Tynogc/PowerSystem/README.md

# PowerSystem
Some Switching regulators, converting a 4S LiPo into 5V and 12V Power Source

Bauteile:
Spuhle 12µH: SRR1260-120MCT-ND
Spuhle 3.3µH: SRN8040-3R3YCT-ND
Spuhle 2.2µH: XFL4020-222MEB (Bei Mouser) Oder gleichwertigen bei DigiKey
