Tynogc/PowerSystem/webench_design_4079392_1_264309184.pdf

## WEBENCH ® Design Report

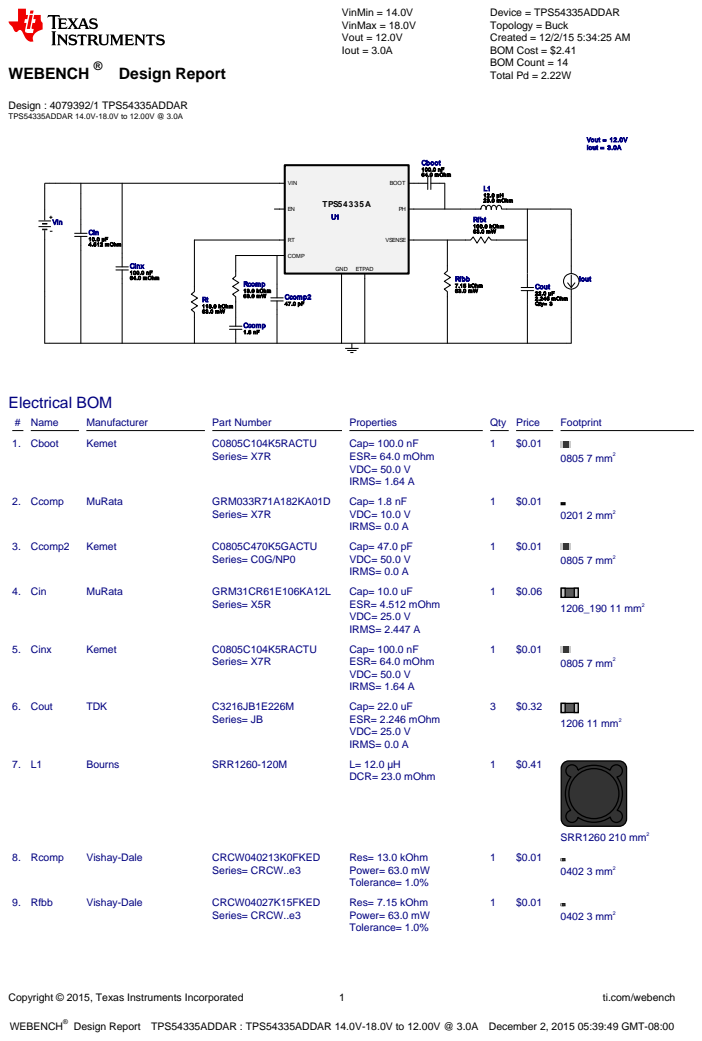
[picture p1: page 1]
Copyright © 2015, Texas Instruments Incorporated; ti.com/webench; WEBENCH®; Design : 4079392/1 TPS54335ADDAR TPS54335ADDAR 14.0V-18.0V to 12.00V @ 3.0A; VinMin = 14.0V VinMax = 18.0V Vout = 12.0V Iout = 3.0A; Device = TPS54335ADDAR Topology = Buck Created = 12/2/15 5:34:25 AM BOM Cost = $2.41 BOM Count = 14 Total Pd = 2.22W; Cboot 100.0 nF 64.0 mOhm; Ccomp 1.8 nF; Ccomp2 47.0 pF; Cin 10.0 µF 4.512 mOhm; Cinx 100.0 nF 64.0 mOhm; Cout 22.0 µF 2.246 mOhm Qty= 3; L1 12.0 µH 23.0 mOhm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

Design Report TPS54335ADDAR : TPS54335ADDAR 14.0V-18.0V to 12.00V @ 3.0A December 2, 2015 05:39:49 GMT-08:00

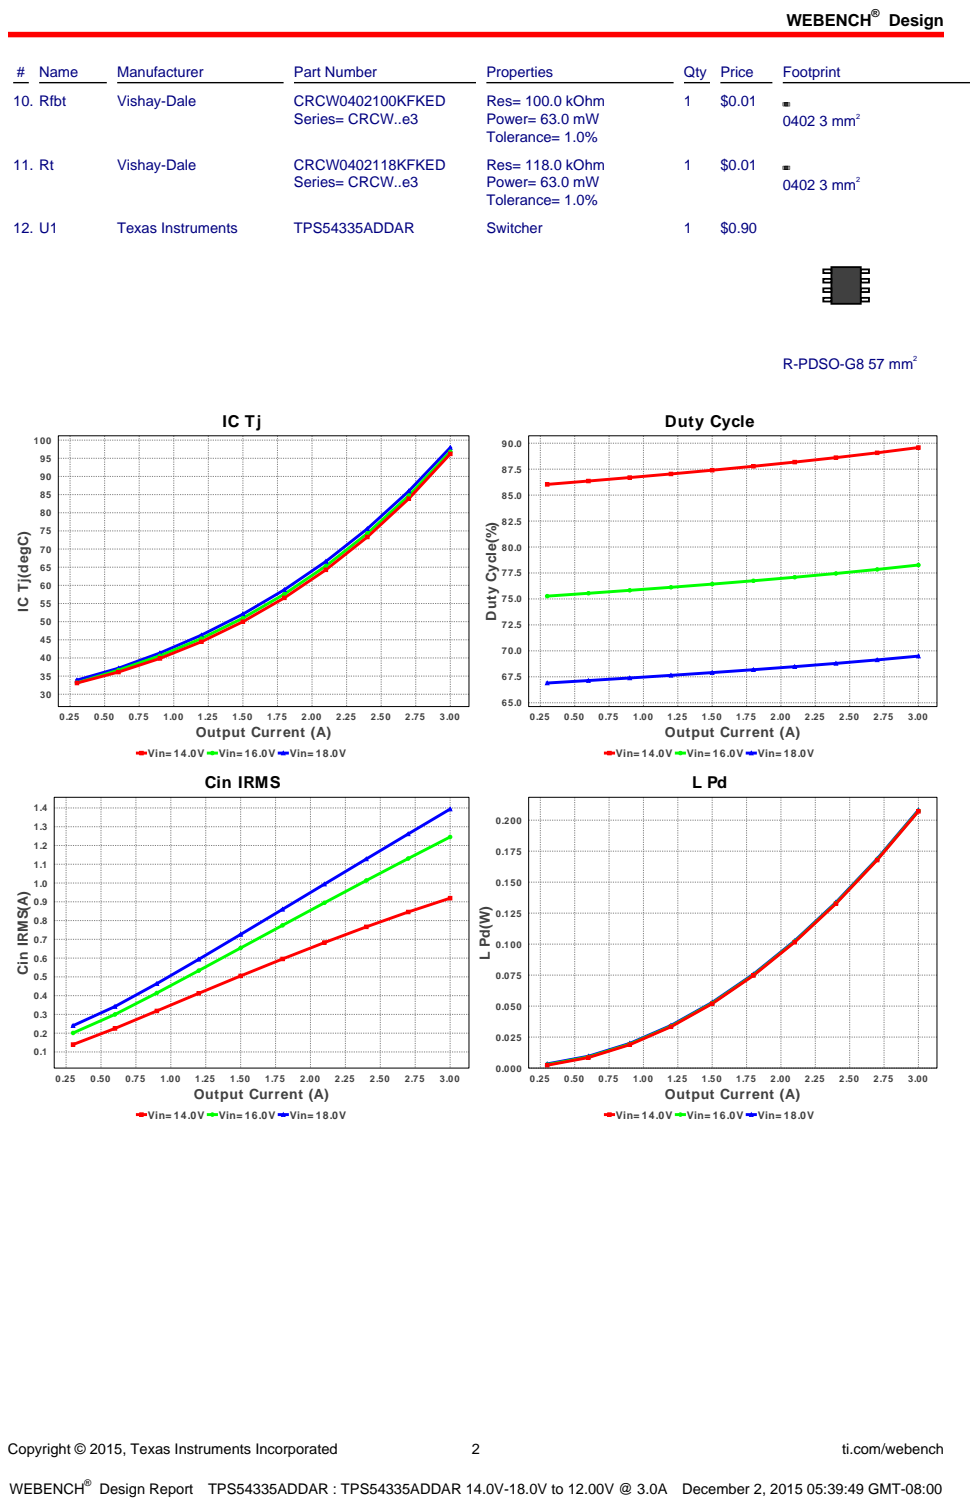
[picture p2: page 2]
Design; Copyright © 2015, Texas Instruments Incorporated; ti.com/webench; # Name; Manufacturer; Part Number; Properties; Qty Price; Footprint; 10. Rfbt; Vishay-Dale; CRCW0402100KFKED; Series= CRCW..e3; Res= 100.0 kOhm Power= 63.0 mW Tolerance= 1.0%; 0402 3 mm²; CRCW0402118KFKED; Res= 118.0 kOhm Power= 63.0 mW Tolerance= 1.0%; Texas Instruments; TPS54335ADDAR; Switcher; R-PDSO-G8 57 mm²; 3.00 Output Current (A); Duty Cycle; Duty Cycle(%); Cin IRMS(A)

IC Tj(degC)

Vin= 14.0V Vin= 16.0V Vin= 18.0V
Cin IRMS

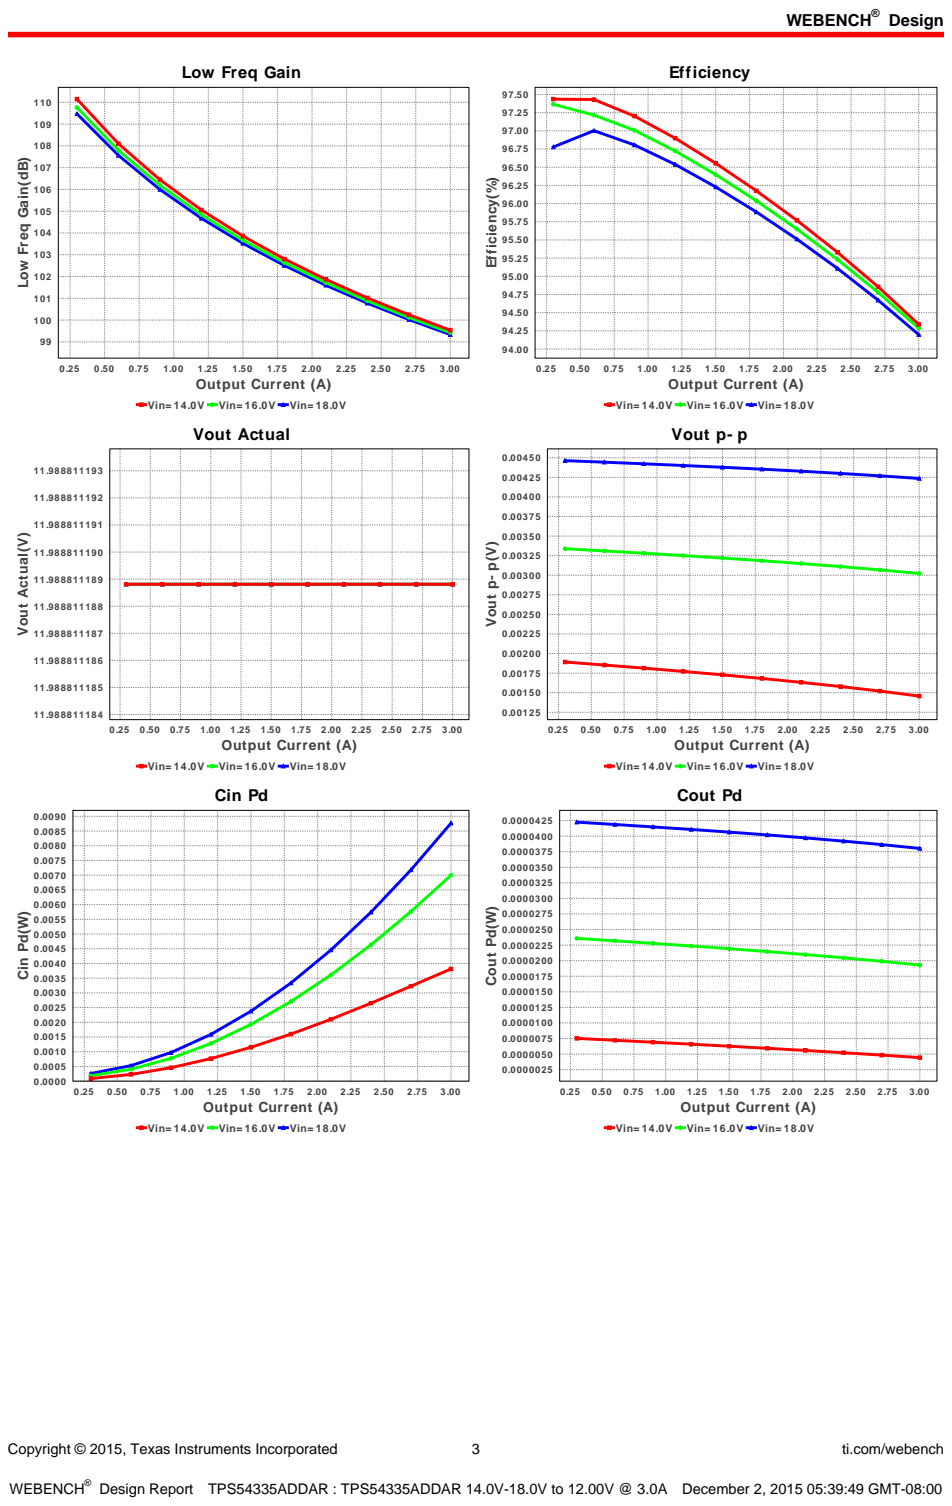
[picture p3: page 3]
Copyright © 2015, Texas Instruments Incorporated; ti.com/webench; 3.00 Output Current (A); Efficiency; Efficiency(%); 0.25 0.50 0.75 1.00 1.25 1.50 1.75 2.00 2.25 2.50 2.75 3.00 Output Current (A); Vout Actual(V); Vout p- p(V); Cin Pd; Cin Pd(W); Cout Pd; Cout Pd(W)

Low Freq Gain

Low Freq Gain(dB)

Vin= 14.0V Vin= 16.0V Vin= 18.0V
Vout Actual

Vout p- p

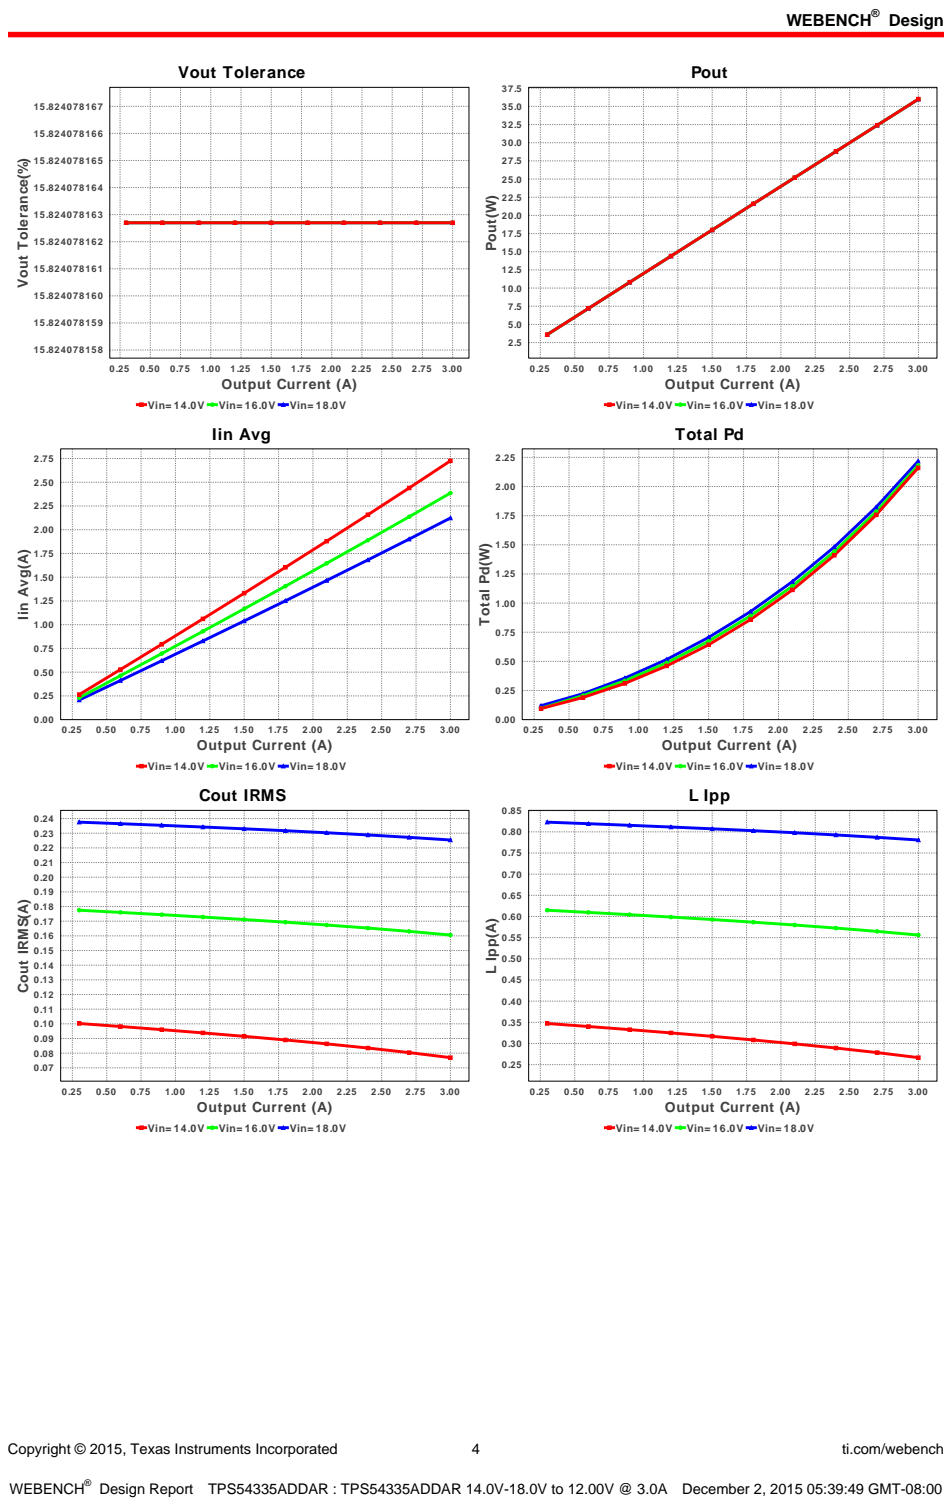
[picture p4: page 4]
Copyright © 2015, Texas Instruments Incorporated; ti.com/webench; Vout Tolerance; 0.25 0.50 0.75 1.00 1.25 1.50 1.75 2.00 2.25 2.50 2.75 3.00 Output Current (A); Vout Tolerance(%); Pout; 3.00 Output Current (A); Pout(W); Iin Avg; Iin Avg(A); Total Pd; Total Pd(W); Cout IRMS(A); L Ipp; L Ipp(A)

Vin= 14.0V Vin= 16.0V Vin= 18.0V

Cout IRMS

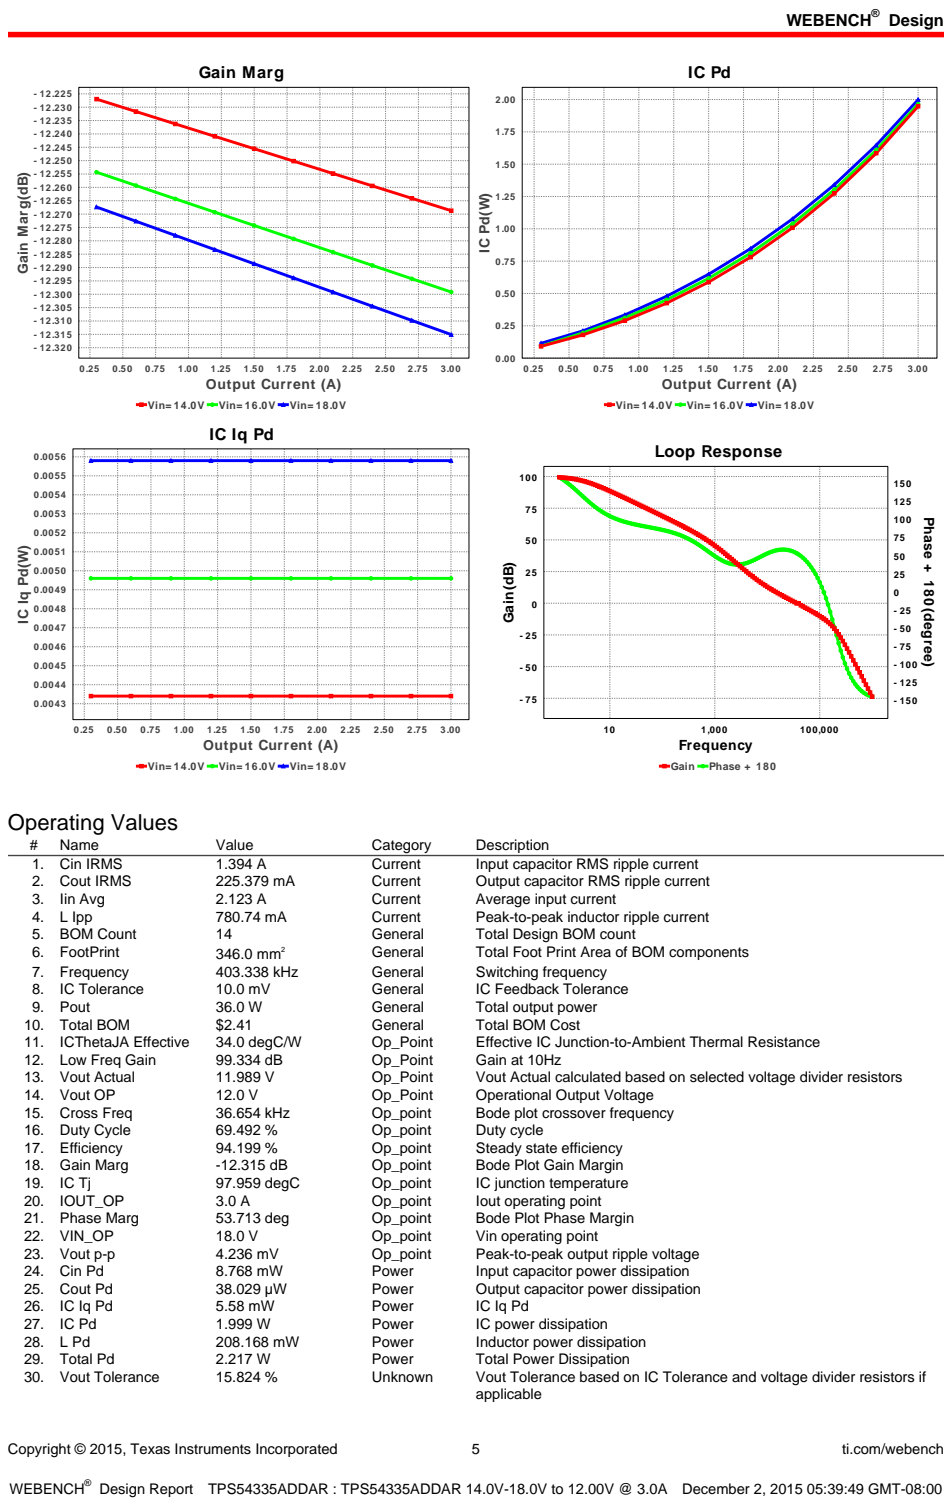
[picture p5: page 5]
Copyright © 2015, Texas Instruments Incorporated; ti.com/webench; Gain Marg; 0.25 0.50 0.75 1.00 1.25 1.50 1.75 2.00 2.25 2.50 2.75 3.00 Output Current (A); 3.00 Output Current (A); Loop Response; Gain Phase + 180; 100,000 Frequency; Gain(dB); Phase + 180(degree); Operating Values; Name; Value; Category; Description; 1. Cin IRMS; Current; Input capacitor RMS ripple current; 2. Cout IRMS; Output capacitor RMS ripple current; 3. Iin Avg; Average input current; 4. L Ipp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

Gain Marg(dB)

Vin= 14.0V Vin= 16.0V Vin= 18.0V

Copyright © 2015, Texas Instruments Incorporated | 6 | ti.com/webench

## Design Inputs

# | Name | Value | Description

1. Iout | 3.0 | Maximum Output Current
2. VinMax | 18.0 | Maximum input voltage
3. VinMin | 14.0 | Minimum input voltage
4. Vout | 12.0 | Output Voltage
5. base_pn | TPS54335A | Base Product Number
6. source | DC | Input Source Type
7. Ta | 30.0 | Ambient temperature

## Design Assistance

1. TPS54335A Product Folder : http://www.ti.com/product/TPS54335A : contains the data sheet and other resources.

Texas Instruments' WEBENCH simulation tools attempt to recreate the performance of a substantially equivalent physical implementation
of the design. Simulations are created using Texas Instruments' published specifications as well as the published specifications of other device manufacturers. While Texas Instruments does update this information periodically, this information may not be current at the time the simulation is built. Texas Instruments does not warrant the accuracy or completeness of the specifications or any information contained therein. Texas Instruments does not warrant that any designs or recommended parts will meet the specifications you entered, will be suitable for your application or fit for any particular purpose, or will operate as shown in the simulation in a physical implementation. Texas Instruments does not warrant that the designs are production worthy.
You should completely validate and test your design implementation to confirm the system functionality for your application prior to production.
Use of Texas Instruments' WEBENCH simulation tools is subject to Texas Instruments' Site Terms and Conditions of Use. (http://www.ti.com/corp/docs/legal/termsofuse.shtml) Prototype boards based on WEBENCH created designs are provided AS IS without warranty of any kind for evaluation and testing purposes and are subject to the terms of the Evaluation License Agreement. (http://www.ti.com/corp/docs/legal/termsofuse_estore.shtml)
