Tynogc/PowerSystem/webench_design_4079392_3_433164948.pdf

## WEBENCH ® Design Report

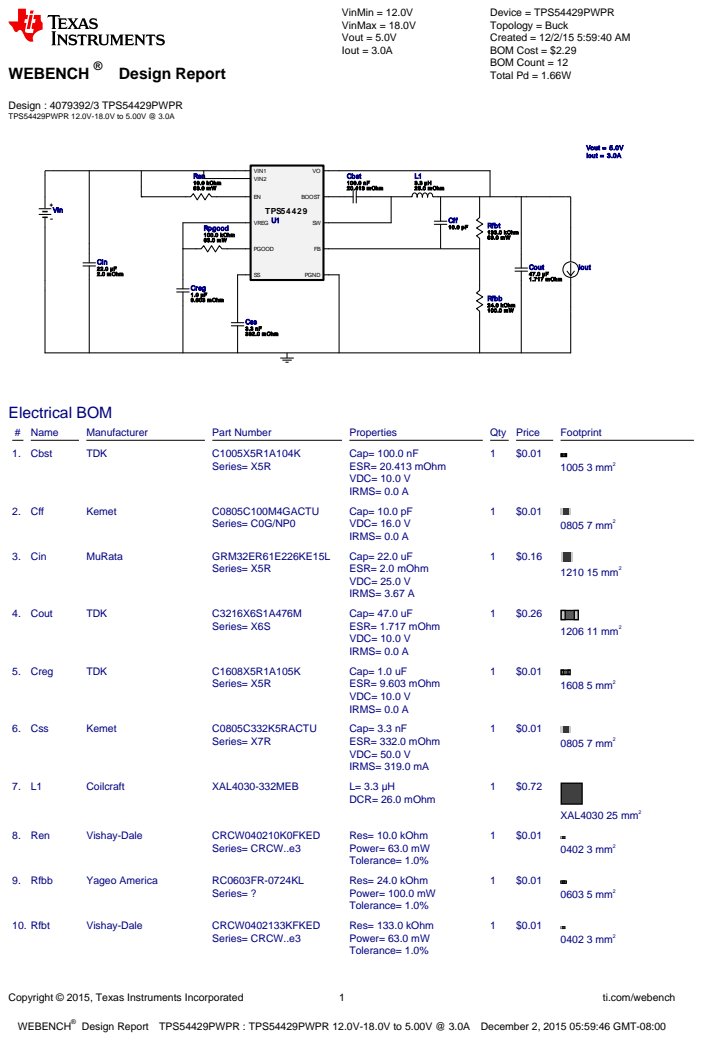
[picture p6: page 1]
Copyright © 2015, Texas Instruments Incorporated; ti.com/webench; WEBENCH®; Design : 4079392/3 TPS54429PWPR TPS54429PWPR 12.0V-18.0V to 5.00V @ 3.0A; VinMin = 12.0V VinMax = 18.0V Vout = 5.0V Iout = 3.0A; Device = TPS54429PWPR Topology = Buck Created = 12/2/15 5:59:40 AM BOM Cost = $2.29 BOM Count = 12 Total Pd = 1.66W; Cff 10.0 pF; Cbst 100.0 nF 20.413 mOhm; Cin 22.0 µF 2.0 mOhm; Cout 47.0 µF 1.717 mOhm; Creg 1.0 µF 9.603 mOhm; Css 3.3 nF 332.0 mOhm; L1 3.3 µH 26.0 mOhm; Ren 10.0 kOhm 63.0 mW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

Design Report TPS54429PWPR : TPS54429PWPR 12.0V-18.0V to 5.00V @ 3.0A December 2, 2015 05:59:46 GMT-08:00

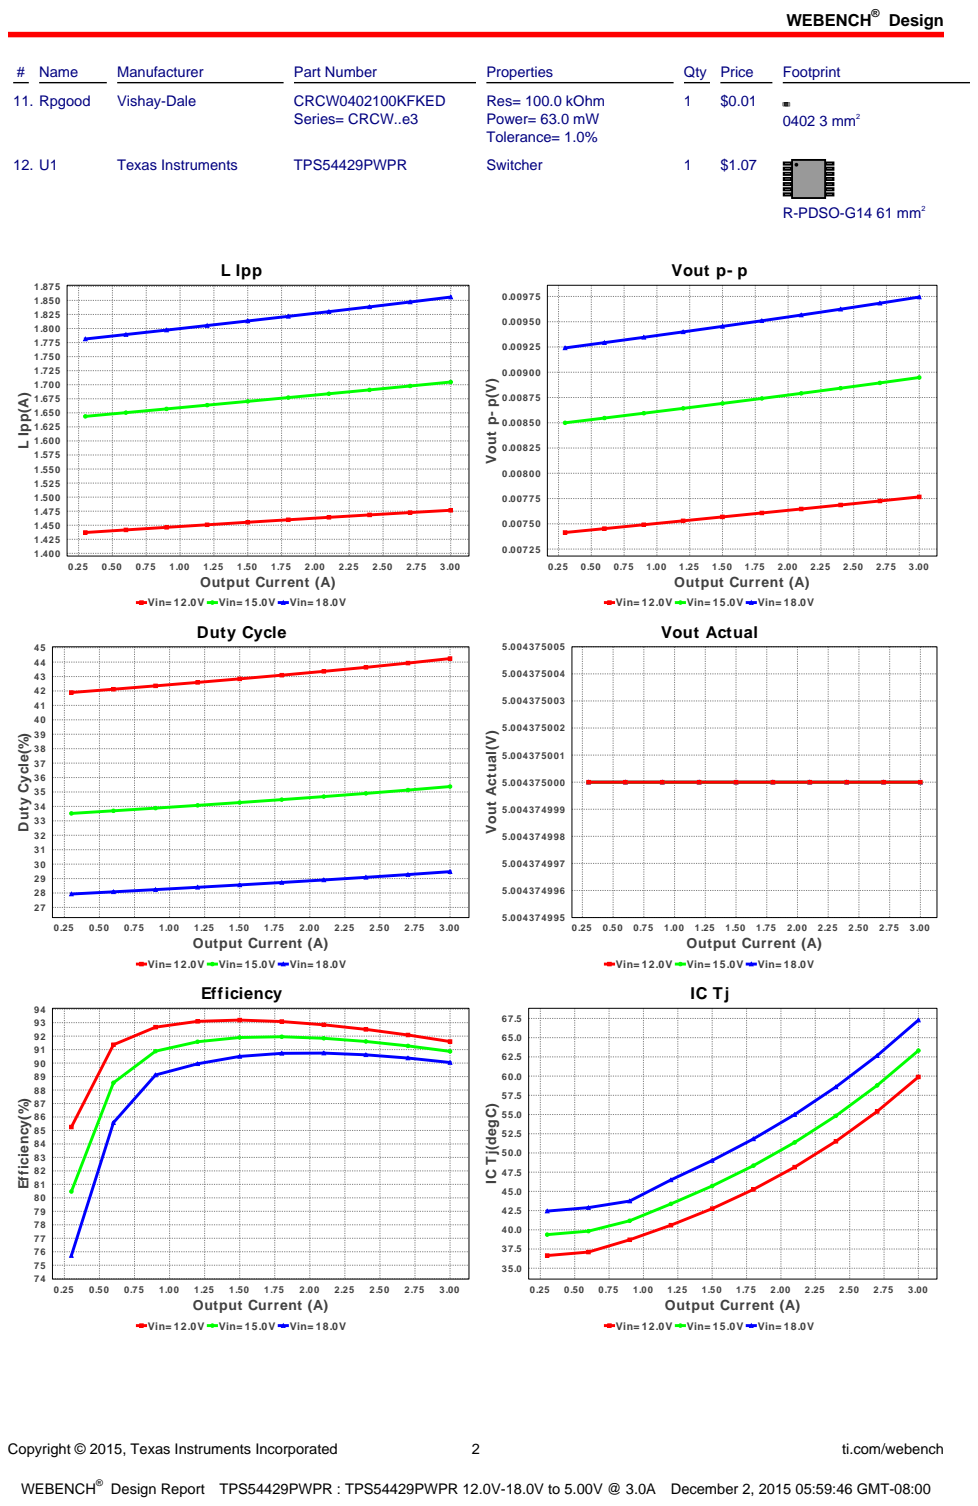
[picture p7: page 2]
Design; Copyright © 2015, Texas Instruments Incorporated; ti.com/webench; # Name; Manufacturer; Part Number; Properties; Qty Price; Footprint; 11. Rpgood; Vishay-Dale; CRCW0402100KFKED; Series= CRCW..e3; Res= 100.0 kOhm Power= 63.0 mW Tolerance= 1.0%; 0402 3 mm²; Texas Instruments; TPS54429PWPR; Switcher; R-PDSO-G14 61 mm²; L Ipp; 3.00 Output Current (A); L Ipp(A); Vout p- p; 0.25 0.50 0.75 1.00 1.25 1.50 1.75 2.00 2.25 2.50 2.75 3.00 Output Current (A); Vout p- p(V); Duty Cycle(%)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

Vin= 12.0V Vin= 15.0V Vin= 18.0V
Duty Cycle

Vout Actual

Efficiency

IC Tj(degC)

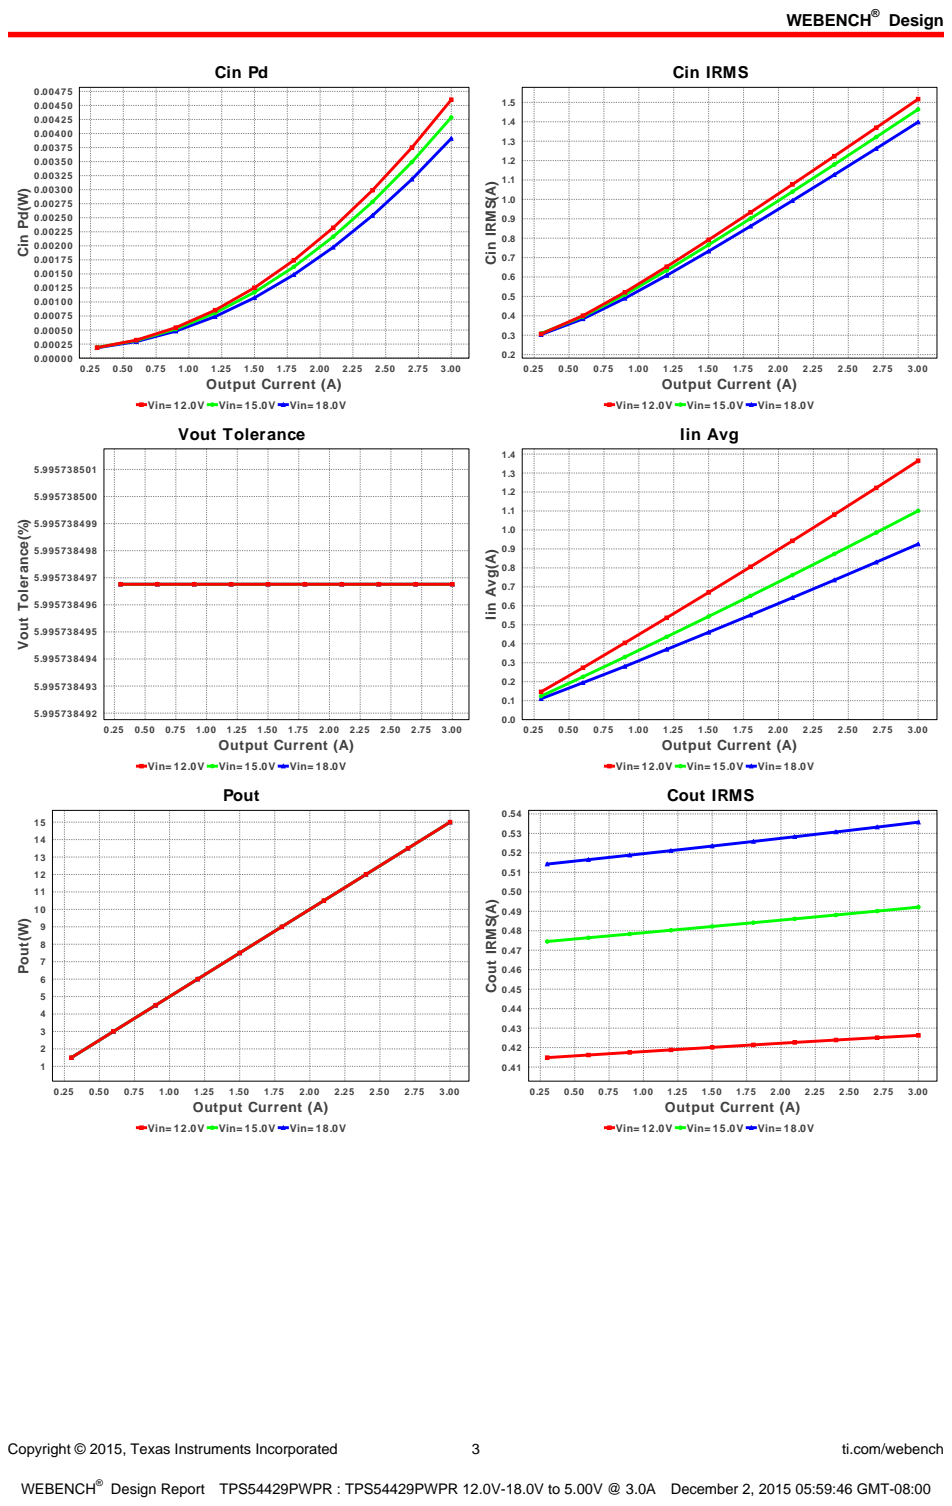
[picture p8: page 3]
Copyright © 2015, Texas Instruments Incorporated; ti.com/webench; Cin Pd; 0.25 0.50 0.75 1.00 1.25 1.50 1.75 2.00 2.25 2.50 2.75 3.00 Output Current (A); Cin Pd(W); Cin IRMS; 3.00 Output Current (A); Cin IRMS(A); Vout Tolerance(%); Iin Avg; Iin Avg(A); Pout; Pout(W); Cout IRMS(A)

Vin= 12.0V Vin= 15.0V Vin= 18.0V
Vout Tolerance

Cout IRMS

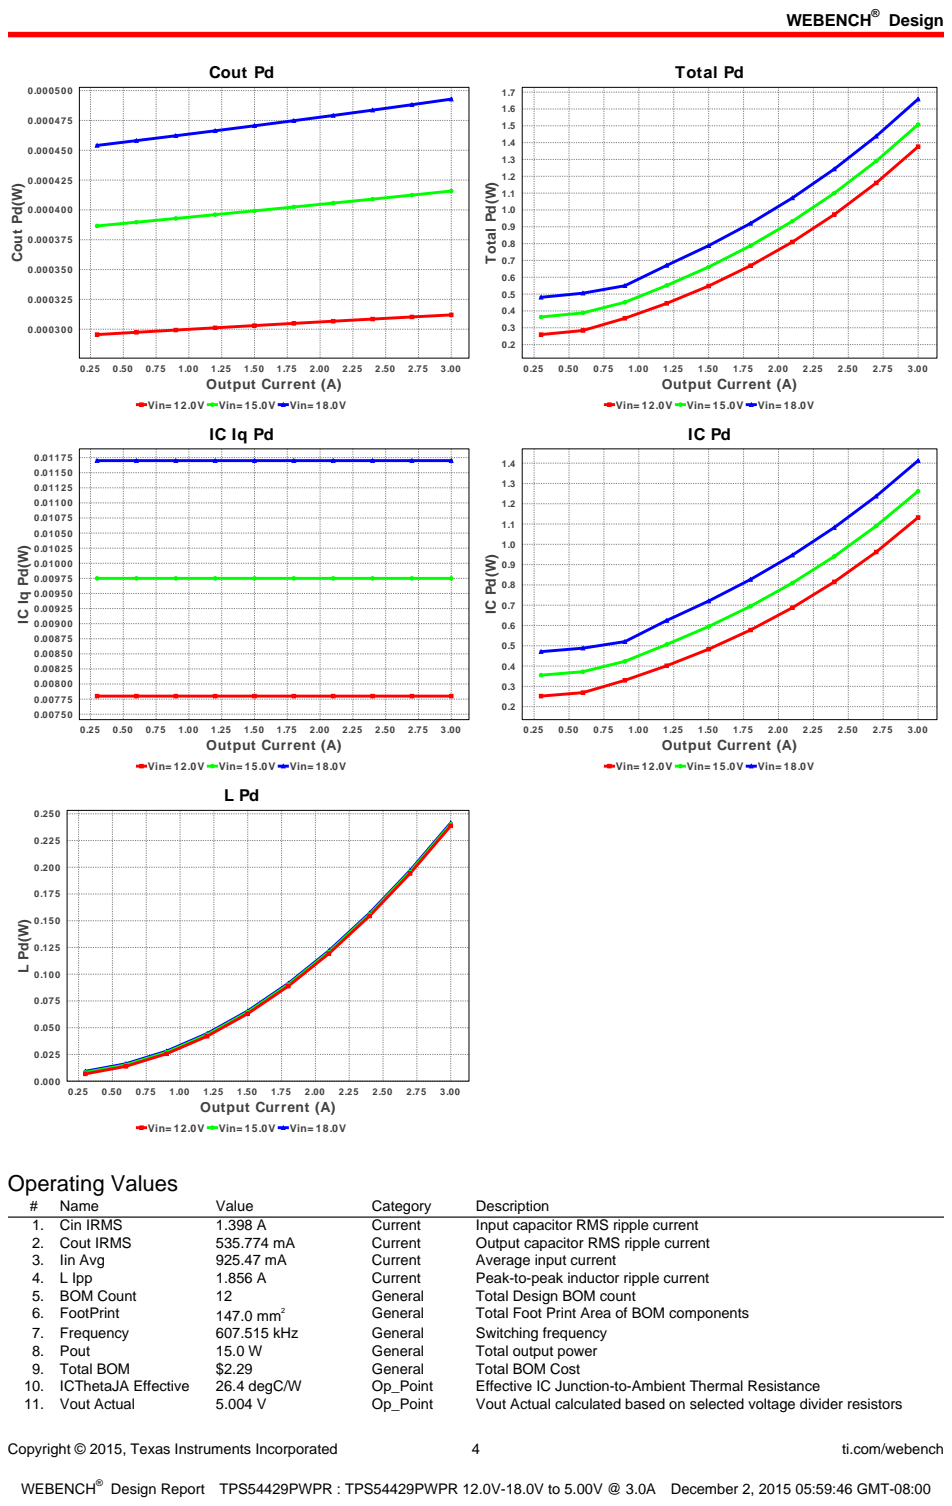
[picture p9: page 4]
Copyright © 2015, Texas Instruments Incorporated; ti.com/webench; Cout Pd; 0.25 0.50 0.75 1.00 1.25 1.50 1.75 2.00 2.25 2.50 2.75 3.00 Output Current (A); Cout Pd(W); Total Pd; 3.00 Output Current (A); Total Pd(W); Operating Values; Name; Value; Category; Description; 1. Cin IRMS; Current; Input capacitor RMS ripple current; 2. Cout IRMS; Output capacitor RMS ripple current; 3. Iin Avg; Average input current; 4. L Ipp; Peak-to-peak inductor ripple current; 5. BOM Count; General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

Vin= 12.0V Vin= 15.0V Vin= 18.0V

Copyright © 2015, Texas Instruments Incorporated | 5 | ti.com/webench
# | Name | Value | Category | Description

12. Vout OP | 5.0 V | Op_Point | Operational Output Voltage
13. Duty Cycle | 29.479 % | Op_point | Duty cycle
14. Efficiency | 90.044 % | Op_point | Steady state efficiency
15. IC Tj | 67.289 degC | Op_point | IC junction temperature
16. IOUT_OP | 3.0 A | Op_point | Iout operating point
17. VIN_OP | 18.0 V | Op_point | Vin operating point
18. Vout p-p | 9.744 mV | Op_point | Peak-to-peak output ripple voltage
19. Cin Pd | 3.911 mW | Power | Input capacitor power dissipation
20. Cout Pd | 492.871 µW | Power | Output capacitor power dissipation
21. IC Iq Pd | 11.7 mW | Power | IC Iq Pd
22. IC Pd | 1.412 W | Power | IC power dissipation
23. L Pd | 241.463 mW | Power | Inductor power dissipation
24. Total Pd | 1.659 W | Power | Total Power Dissipation
25. Vout Tolerance | 5.996 % | Unknown | Vout Tolerance based on IC Tolerance and voltage divider resistors if
| | | | applicable

## Design Inputs

# | Name | Value | Description

1. Iout | 3.0 | Maximum Output Current
2. VinMax | 18.0 | Maximum input voltage
3. VinMin | 12.0 | Minimum input voltage
4. Vout | 5.0 | Output Voltage
5. base_pn | TPS54429 | Base Product Number
6. source | DC | Input Source Type
7. Ta | 30.0 | Ambient temperature

## Design Assistance

1. TPS54429 Product Folder : http://www.ti.com/product/TPS54429 : contains the data sheet and other resources.

Texas Instruments' WEBENCH simulation tools attempt to recreate the performance of a substantially equivalent physical implementation
of the design. Simulations are created using Texas Instruments' published specifications as well as the published specifications of other device manufacturers. While Texas Instruments does update this information periodically, this information may not be current at the time the simulation is built. Texas Instruments does not warrant the accuracy or completeness of the specifications or any information contained therein. Texas Instruments does not warrant that any designs or recommended parts will meet the specifications you entered, will be suitable for your application or fit for any particular purpose, or will operate as shown in the simulation in a physical implementation. Texas Instruments does not warrant that the designs are production worthy.
You should completely validate and test your design implementation to confirm the system functionality for your application prior to production.
Use of Texas Instruments' WEBENCH simulation tools is subject to Texas Instruments' Site Terms and Conditions of Use. (http://www.ti.com/corp/docs/legal/termsofuse.shtml) Prototype boards based on WEBENCH created designs are provided AS IS without warranty of any kind for evaluation and testing purposes and are subject to the terms of the Evaluation License Agreement. (http://www.ti.com/corp/docs/legal/termsofuse_estore.shtml)
