Tynogc/PowerSystem/PwrRails.kicad_pcb

## KiCad design PwrRails.kicad_pcb (2015-12-04)

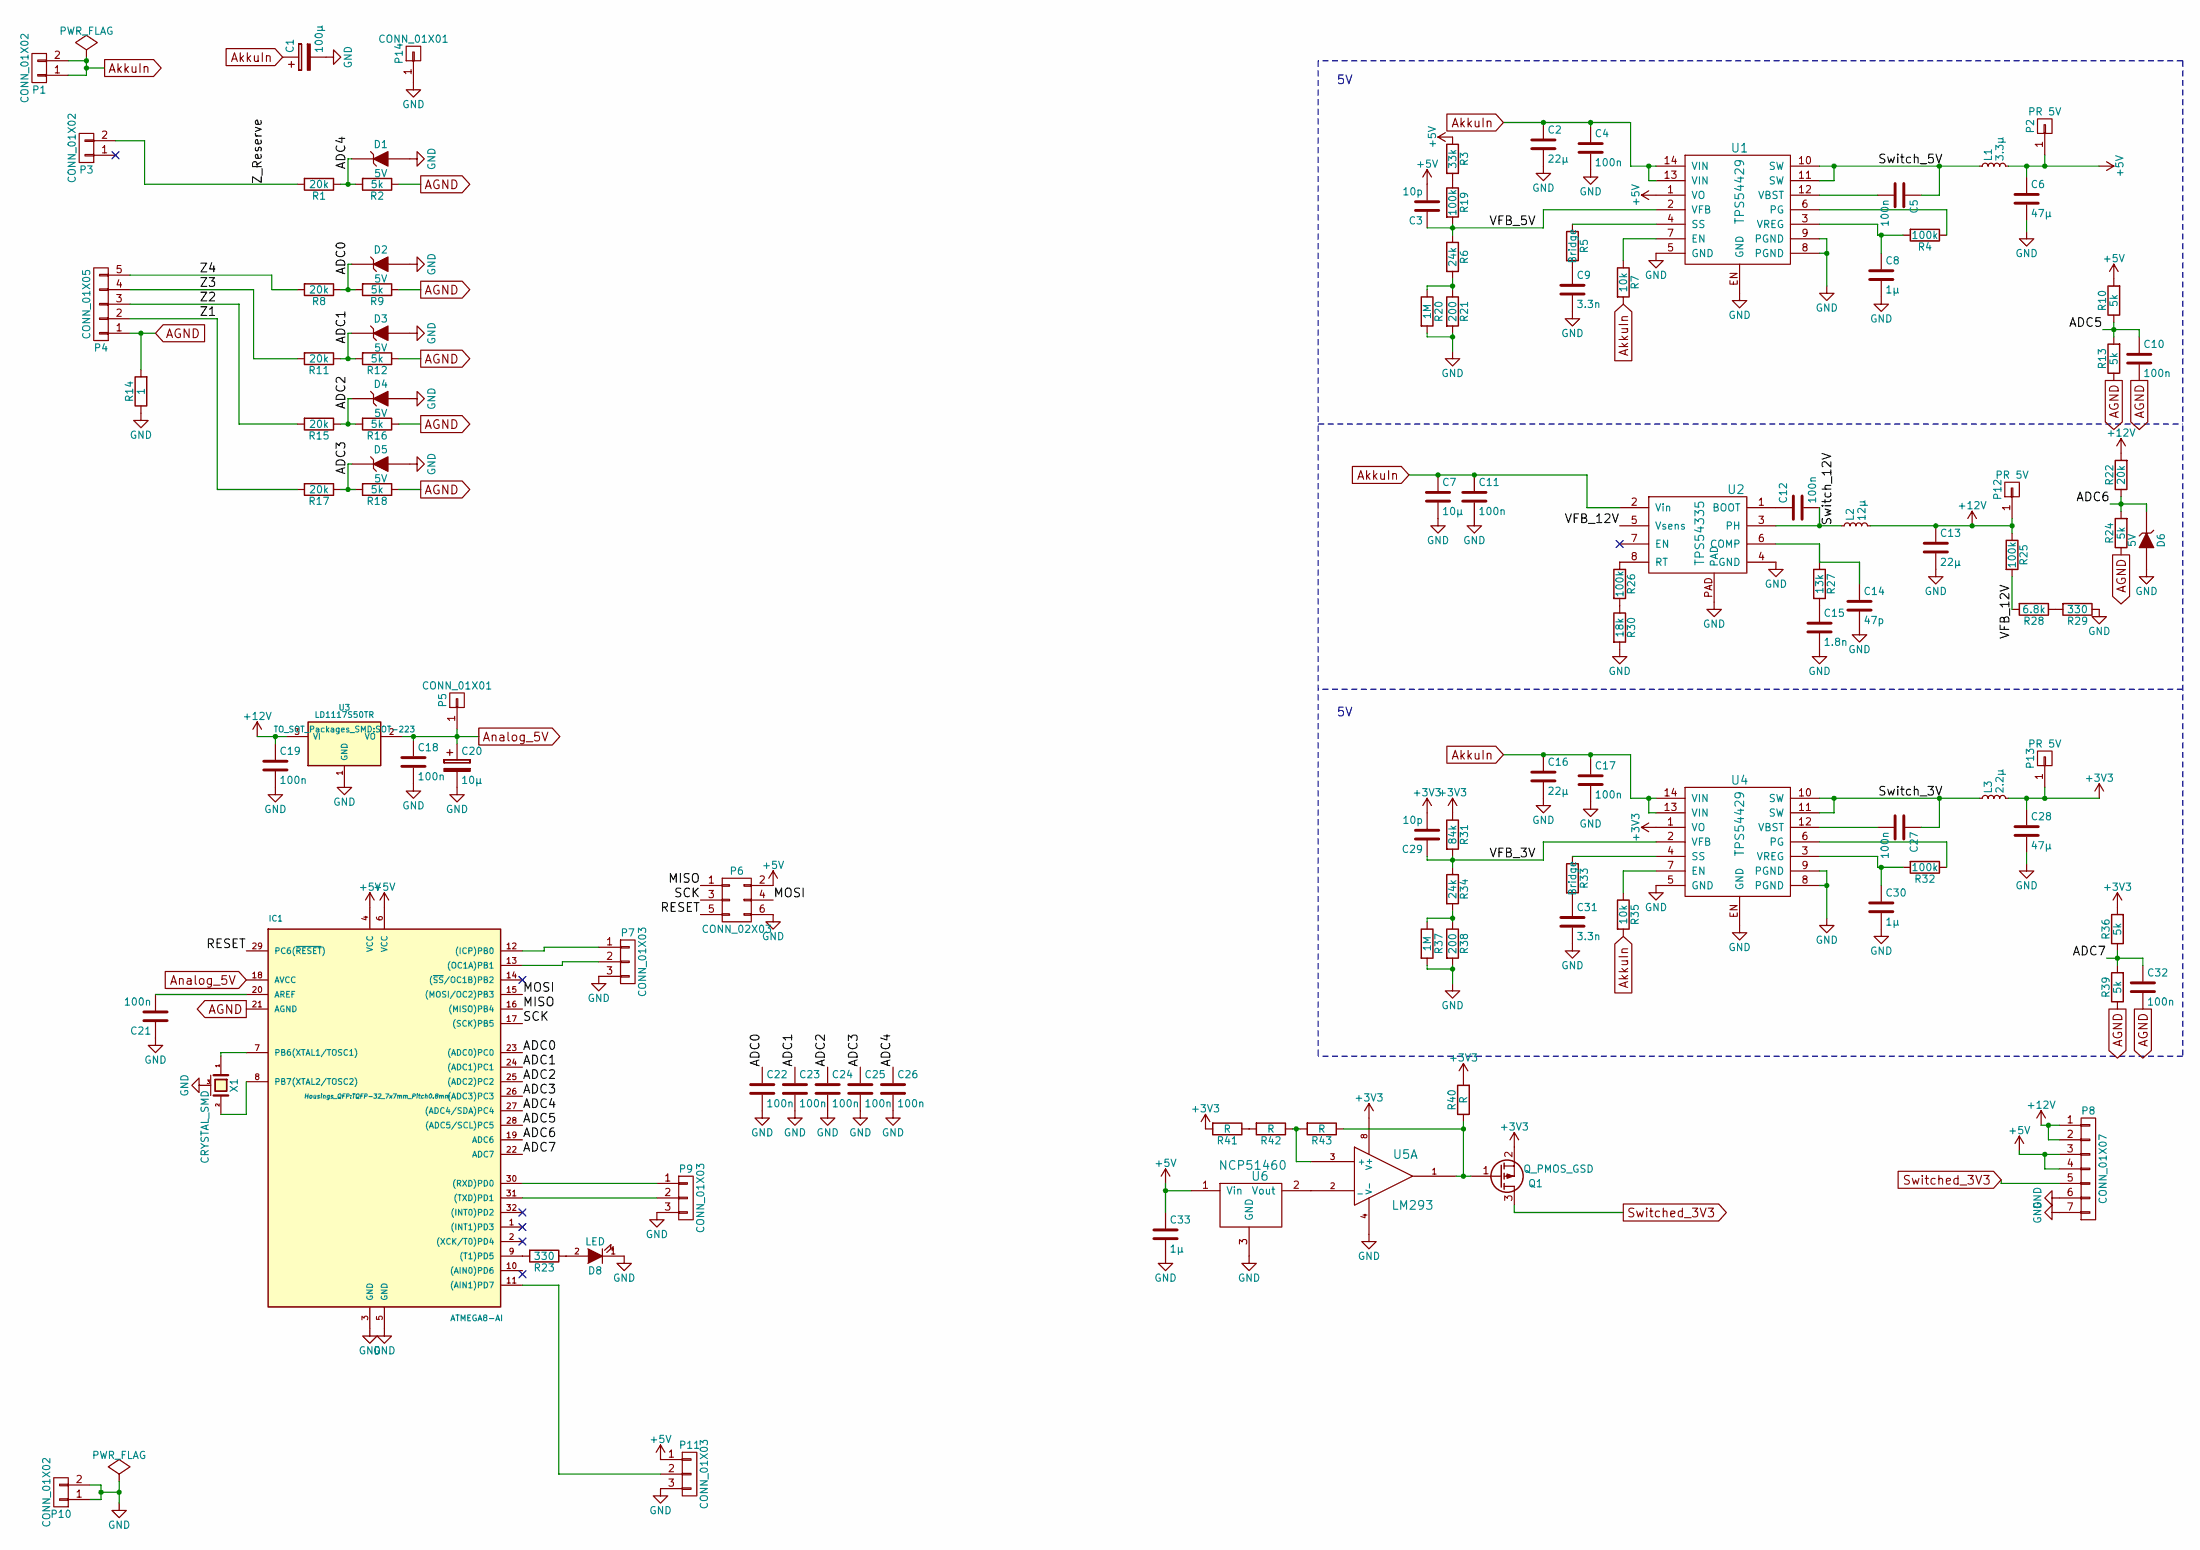
[picture p10: schematic PwrRails.sch]

Parts:
C1: 100µ; C_Radial_D8_L13_P3.8
C2, C16: 22µ; C_1210
C3, C29: 10p; C_0603
C4, C5, C10, C11, C12, C17, C18, C19, C21, C22, C23, C24, C25, C26, C27, C32: 100n; C_0805
C6, C28: 47µ; C_1206
C7, C20: 10µ; C_1206
C8, C30, C33: 1µ; C_0805
C9, C31: 3.3n; C_0805
C13: 22µ; C_1206
C14: 47p; C_0603
C15: 1.8n; C_0603
D1, D2, D3, D4, D5, D6: 5V; MiniMELF_Standard
D8: LED; LED-0805
IC1: ATMEGA8-AI; TQFP-32_7x7mm_Pitch0.8mm
L1: 3.3µ; Z_Borus_SRN8040
L2: 12µ; Neosid_Inductor_SM-NE127
L3: 2.2µ; Z_Coilcraft_XFL4020
P1, P10: CONN_01X02; Screw_Connector_5,08mm_x2
P2, P12, P13: PR 5V; Measurement_Point_Square-SMD-Pad_Big
P3: CONN_01X02; Socket_Strip_Straight_1x02
P4: CONN_01X05; Socket_Strip_Straight_1x05
P5, P14: CONN_01X01; Socket_Strip_Straight_1x01
P6: CONN_02X03; Socket_Strip_Straight_2x03
P7, P9, P11: CONN_01X03; Socket_Strip_Straight_1x03
P8: CONN_01X07; Socket_Strip_Straight_1x07
Q1: Q_PMOS_GSD; SOT-23
R1, R8, R11, R15, R17, R22: 20k; R_0603
R2, R9, R10, R12, R13, R16, R18, R24, R36, R39: 5k; R_0603
R3: 33k; R_0603
R4, R19, R25, R26, R32: 100k; R_0603
R5, R33: Bridge; R_0603
R6, R34: 24k; R_0603
R7, R35: 10k; R_0603
R14: 1; R_0603
R20, R37: 1M; R_0603
R21, R38: 200; R_0603
R23, R29: 330; R_0603
R27: 13k; R_0603
R28: 6.8k; R_0603
R30: 18k; R_0603
R31: 84k; R_0603
R40, R41, R42, R43: R; R_0603
U1, U4: TPS54429; TSSOP-14_4.4x5mm_PowerPad
U2: TPS54335; SOIC-8-N-PowerPAD
U3: LD1117S50TR; SOT-223
U5: LM293; SOIC-8-N
U6: NCP51460; SOT-23
X1: CRYSTAL_SMD; CerOsc_3,2x1,3

Connections:
+3V3: C28.1, C29.2, L3.2, P13.1, Q1.2 (S), R31.1, R36.2, R40.2, R41.2, U4.1 (VO), U5.8 (V+)
+5V: C3.2, C6.1, C33.1, IC1.4 (VCC), IC1.6 (VCC), L1.2, P2.1, P6.2, P8.3, P8.4, P11.1, R3.1, R10.2, U1.1 (VO), U6.1 (Vin)
+12V: C13.1, C19.1, L2.2, P8.1, P8.2, P12.1, R22.2, R25.1, U3.3 (VI)
/ADC0: C22.1, D2.1 (K), IC1.23 ((ADC0)PC0), R8.1, R9.2
/ADC1: C23.1, D3.1 (K), IC1.24 ((ADC1)PC1), R11.1, R12.2
/ADC2: C24.1, D4.1 (K), IC1.25 ((ADC2)PC2), R15.1, R16.2
/ADC3: C25.1, D5.1 (K), IC1.26 ((ADC3)PC3), R17.1, R18.2
/ADC4: C26.1, D1.1 (K), IC1.27 ((ADC4/SDA)PC4), R1.1, R2.2
/ADC5: C10.1, IC1.28 ((ADC5/SCL)PC5), R10.1, R13.2
/ADC6: D6.1 (K), IC1.19 (ADC6), R22.1, R24.2
/ADC7: C32.1, IC1.22 (ADC7), R36.1, R39.2
/MISO: IC1.16 ((MISO)PB4), P6.1
/MOSI: IC1.15 ((MOSI/OC2)PB3), P6.4
/RESET: IC1.29 (PC6(~RESET~)), P6.5
/SCK: IC1.17 ((SCK)PB5), P6.3
/Switch_3V: C27.1, L3.1, U4.10 (SW), U4.11 (SW)
/Switch_5V: C5.1, L1.1, U1.10 (SW), U1.11 (SW)
/Switch_12V: C12.2, L2.1, U2.3 (PH)
/VFB_3V: C29.1, R31.2, R34.1, U4.2 (VFB)
/VFB_5V: C3.1, R6.1, R19.2, U1.2 (VFB)
/VFB_12V: R25.2, R28.2, U2.5 (Vsens)
/Z1: P4.2, R17.2
/Z2: P4.3, R15.2
/Z3: P4.4, R11.2
/Z4: P4.5, R8.2
/Z_Reserve: P3.2, R1.2
AGND: C10.2, C32.2, IC1.21 (AGND), P4.1, R2.1, R9.1, R12.1, R13.1, R14.2, R16.1, R18.1, R24.1, R39.1
AkkuIn: C1.1, C2.1, C4.1, C7.1, C11.1, C16.1, C17.1, P1.1, P1.2, R7.2, R35.2, U1.13 (VIN), U1.14 (VIN), U2.2 (Vin), U4.13 (VIN), U4.14 (VIN)
Analog_5V: C18.1, C20.1, IC1.18 (AVCC), P5.1, U3.2 (VO)
GND: C1.2, C2.2, C4.2, C6.2, C7.2, C8.2, C9.2, C11.2, C13.2, C14.2, C15.2, C16.2, C17.2, C18.2, C19.2, C20.2, C21.1, C22.2, C23.2, C24.2, C25.2, C26.2, C28.2, C30.2, C31.2, C33.2, D1.2 (A), D2.2 (A), D3.2 (A), D4.2 (A), D5.2 (A), D6.2 (A), D8.1 (K), IC1.3 (GND), IC1.5 (GND), P6.6, P7.3, P8.6, P8.7, P9.3, P10.1, P10.2, P11.3, P14.1, R14.1, R20.2, R21.2, R29.1, R30.2, R37.2, R38.2, U1.5 (GND), U1.8 (PGND), U1.9 (PGND), U1.EN (GND), U2.4 (GND), U2.PAD, U3.1 (GND), U4.5 (GND), U4.8 (PGND), U4.9 (PGND), U4.EN (GND), U5.4 (V-), U6.3 (GND), X1.3 (case)
unnamed: C5.2, U1.12 (VBST)
unnamed: C8.1, R4.2, U1.3 (VREG)
unnamed: C9.1, R5.2
unnamed: C12.1, U2.1 (BOOT)
unnamed: C14.1, R27.1, U2.6 (COMP)
unnamed: C15.1, R27.2
unnamed: C21.2, IC1.20 (AREF)
unnamed: C27.2, U4.12 (VBST)
unnamed: C30.1, R32.2, U4.3 (VREG)
unnamed: C31.1, R33.2
unnamed: D8.2 (A), R23.1
unnamed: IC1.7 (PB6(XTAL1/TOSC1)), X1.1
unnamed: IC1.8 (PB7(XTAL2/TOSC2)), X1.2
unnamed: IC1.9 ((T1)PD5), R23.2
unnamed: IC1.11 ((AIN1)PD7), P11.2
unnamed: IC1.12 ((ICP)PB0), P7.1
unnamed: IC1.13 ((OC1A)PB1), P7.2
unnamed: IC1.30 ((RXD)PD0), P9.1
unnamed: IC1.31 ((TXD)PD1), P9.2
unnamed: Q1.1 (G), R40.1, R43.1, U5.1
unnamed: R4.1, U1.6 (PG)
unnamed: R5.1, U1.4 (SS)
unnamed: R7.1, U1.7 (EN)
unnamed: R3.2, R19.1
unnamed: R6.2, R20.1, R21.1
unnamed: R26.1, U2.8 (RT)
unnamed: R26.2, R30.1
unnamed: R28.1, R29.2
unnamed: R32.1, U4.6 (PG)
unnamed: R33.1, U4.4 (SS)
unnamed: R34.2, R37.1, R38.1
unnamed: R35.1, U4.7 (EN)
unnamed: R41.1, R42.2
unnamed: R42.1, R43.2, U5.3 (+)
unnamed: U5.2 (_), U6.2 (Vout)
Switched_3V3: P8.5, Q1.3 (D)

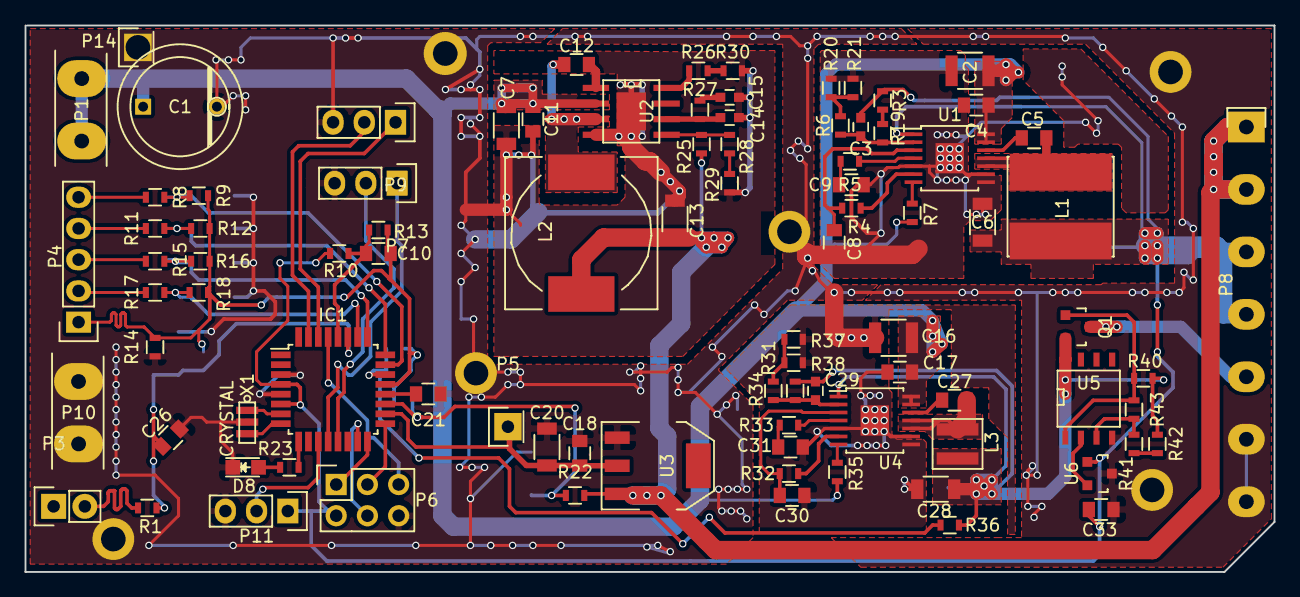
[picture p11: board PwrRails.kicad_pcb from above]

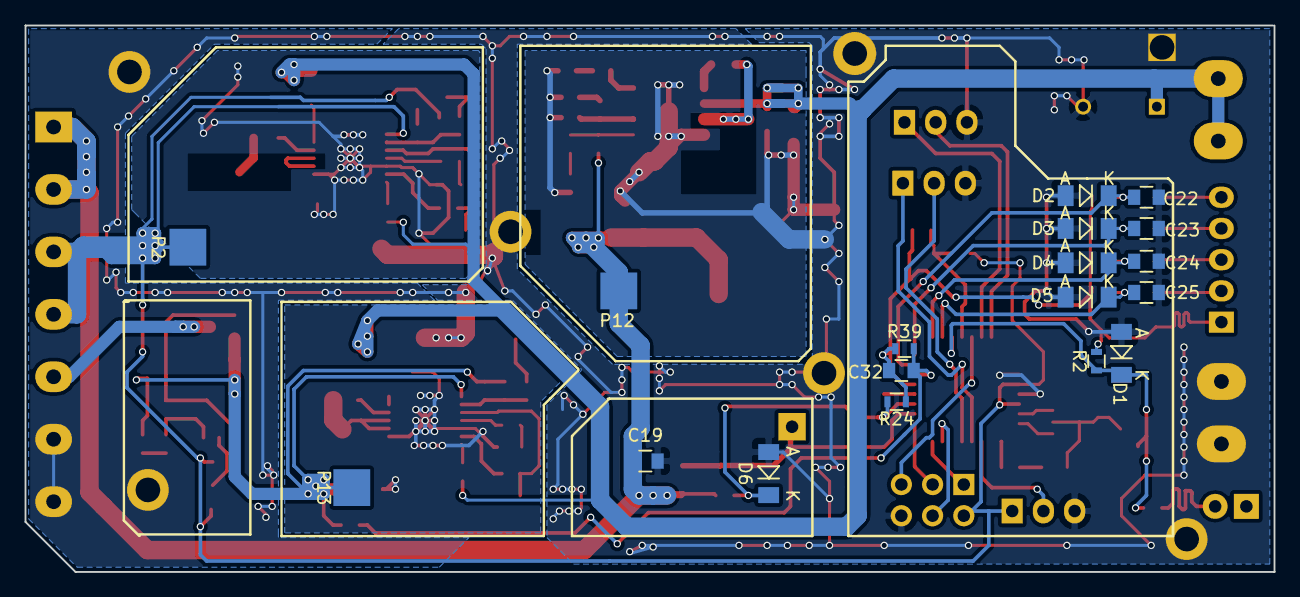
[picture p12: board PwrRails.kicad_pcb from below]

Board: 2 copper layers, 101.6 x 44.5 mm, 109 parts (18 on the bottom side), 66 nets.
