Tynogc/PowerSystem/(commit log)

2015-12-02 Added ALL Files :-)
    [PwrRails.kicad_pcb, PwrRails.sch]
2015-12-02 12V Seite fast fertig
    [PwrRails.kicad_pcb, PwrRails.sch]
2015-12-03 PCB quasi fertig!
    [PwrRails.kicad_pcb, PwrRails.sch]
2015-12-03 Bohrungen hinzugefügt.
    [PwrRails.kicad_pcb, PwrRails.sch]
2015-12-04 Lötstopp-Auspahrungen und Beschtückungsdruck ist fertig!
    [PwrRails.kicad_pcb, PwrRails.sch]
2015-12-04 Gerber erzeugt
    [PwrRails-B.Cu.gbl, PwrRails-B.Mask.gbs, PwrRails-B.SilkS.gbo, PwrRails-Edge.Cuts.gm1, PwrRails-F.Cu.gtl, PwrRails-F.Mask.gts, PwrRails-F.SilkS.gto, PwrRails.drl]
